Macquarie-Aerospace-Rover-Society/schematics/README.md

# ALL THINGS ELECTRICAL
All the schematics and manufacturing files will be located here.

If there are any requests, corrections or objections, please direct them at @sunnyshenao on the MQ rover discord.
