Macquarie-Aerospace-Rover-Society/schematics/mqmars.kicad_pcb

## KiCad design mqmars.kicad_pcb (2024-12-28)

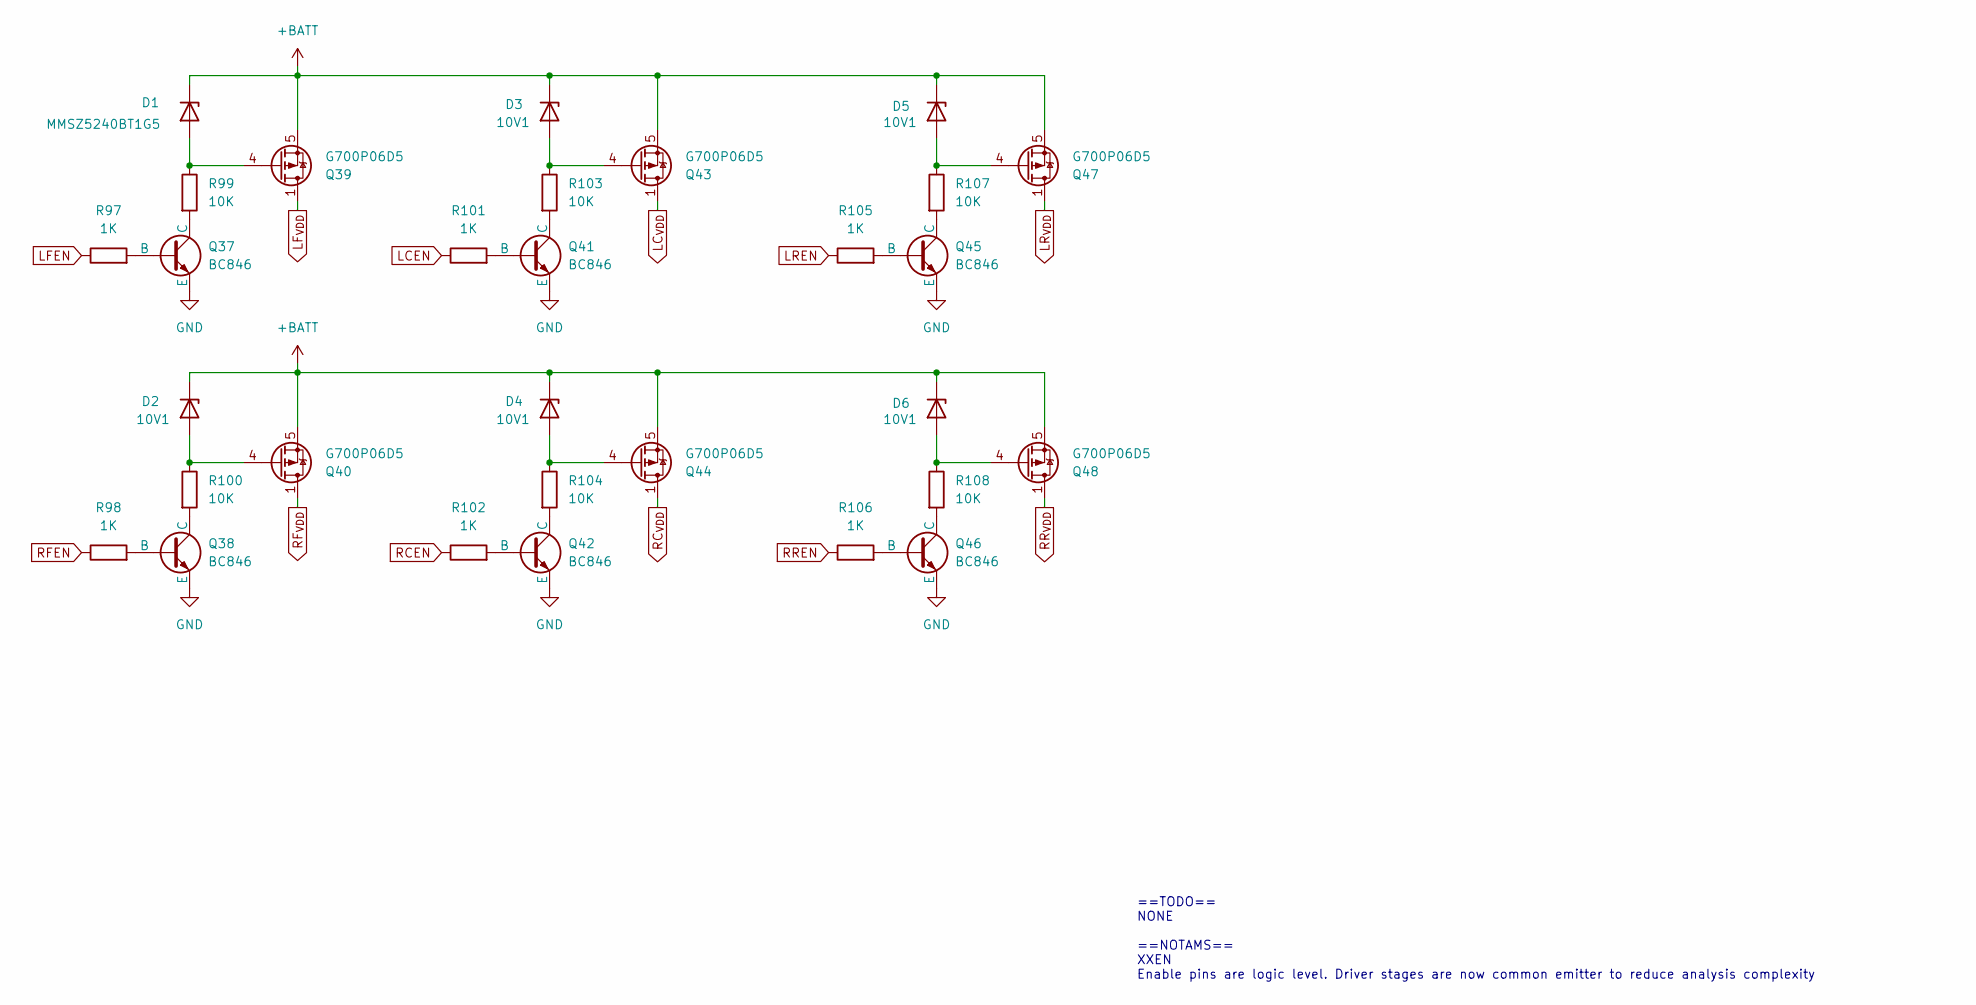
[picture p1: schematic PDU.kicad_sch, MQ Rover Controller]

Parts:
D1: MMSZ5240BT1G5; D_SOD-123
D2, D3, D4, D5, D6: 10V1; D_SOD-123
Q37, Q38, Q41, Q42, Q45, Q46: BC846; SOT-23
Q39, Q40, Q43, Q44, Q47, Q48: G700P06D5; PowerPAK_SO-8_Single
R97, R98, R101, R102, R105, R106: 1K; R_0201_0603Metric
R99, R100, R103, R104, R107, R108: 10K; R_1210_3225Metric

Connections:
+BATT: D1.1 (K), D2.1 (K), D3.1 (K), D4.1 (K), D5.1 (K), D6.1 (K), Q39.5 (S), Q40.5 (S), Q43.5 (S), Q44.5 (S), Q47.5 (S), Q48.5 (S); also elsewhere on the board
GND: Q37.3 (E), Q38.3 (E), Q41.3 (E), Q42.3 (E), Q45.3 (E), Q46.3 (E); also elsewhere on the board
LCEN: R101.1; also elsewhere on the board
LC_{VDD}: Q43.1 (D), Q43.2 (D), Q43.3 (D); also elsewhere on the board
LFEN: R97.1; also elsewhere on the board
LF_{VDD}: Q39.1 (D), Q39.2 (D), Q39.3 (D); also elsewhere on the board
LREN: R105.1; also elsewhere on the board
LR_{VDD}: Q47.1 (D), Q47.2 (D), Q47.3 (D); also elsewhere on the board
unnamed: D1.2 (A), Q39.4 (G), R99.1
unnamed: D2.2 (A), Q40.4 (G), R100.1
unnamed: D3.2 (A), Q43.4 (G), R103.1
unnamed: D4.2 (A), Q44.4 (G), R104.1
unnamed: D5.2 (A), Q47.4 (G), R107.1
unnamed: D6.2 (A), Q48.4 (G), R108.1
unnamed: Q37.2 (B), R97.2
unnamed: Q37.1 (C), R99.2
unnamed: Q38.2 (B), R98.2
unnamed: Q38.1 (C), R100.2
unnamed: Q41.2 (B), R101.2
unnamed: Q41.1 (C), R103.2
unnamed: Q42.2 (B), R102.2
unnamed: Q42.1 (C), R104.2
unnamed: Q45.2 (B), R105.2
unnamed: Q45.1 (C), R107.2
unnamed: Q46.2 (B), R106.2
unnamed: Q46.1 (C), R108.2
RCEN: R102.1; also elsewhere on the board
RC_{VDD}: Q44.1 (D), Q44.2 (D), Q44.3 (D); also elsewhere on the board
RFEN: R98.1; also elsewhere on the board
RF_{VDD}: Q40.1 (D), Q40.2 (D), Q40.3 (D); also elsewhere on the board
RREN: R106.1; also elsewhere on the board
RR_{VDD}: Q48.1 (D), Q48.2 (D), Q48.3 (D); also elsewhere on the board

Notes on the sheet:
==TODO== NONE ==NOTAMS== XXEN Enable pins are logic level. Driver stages are now common emitter to reduce analysis complexity

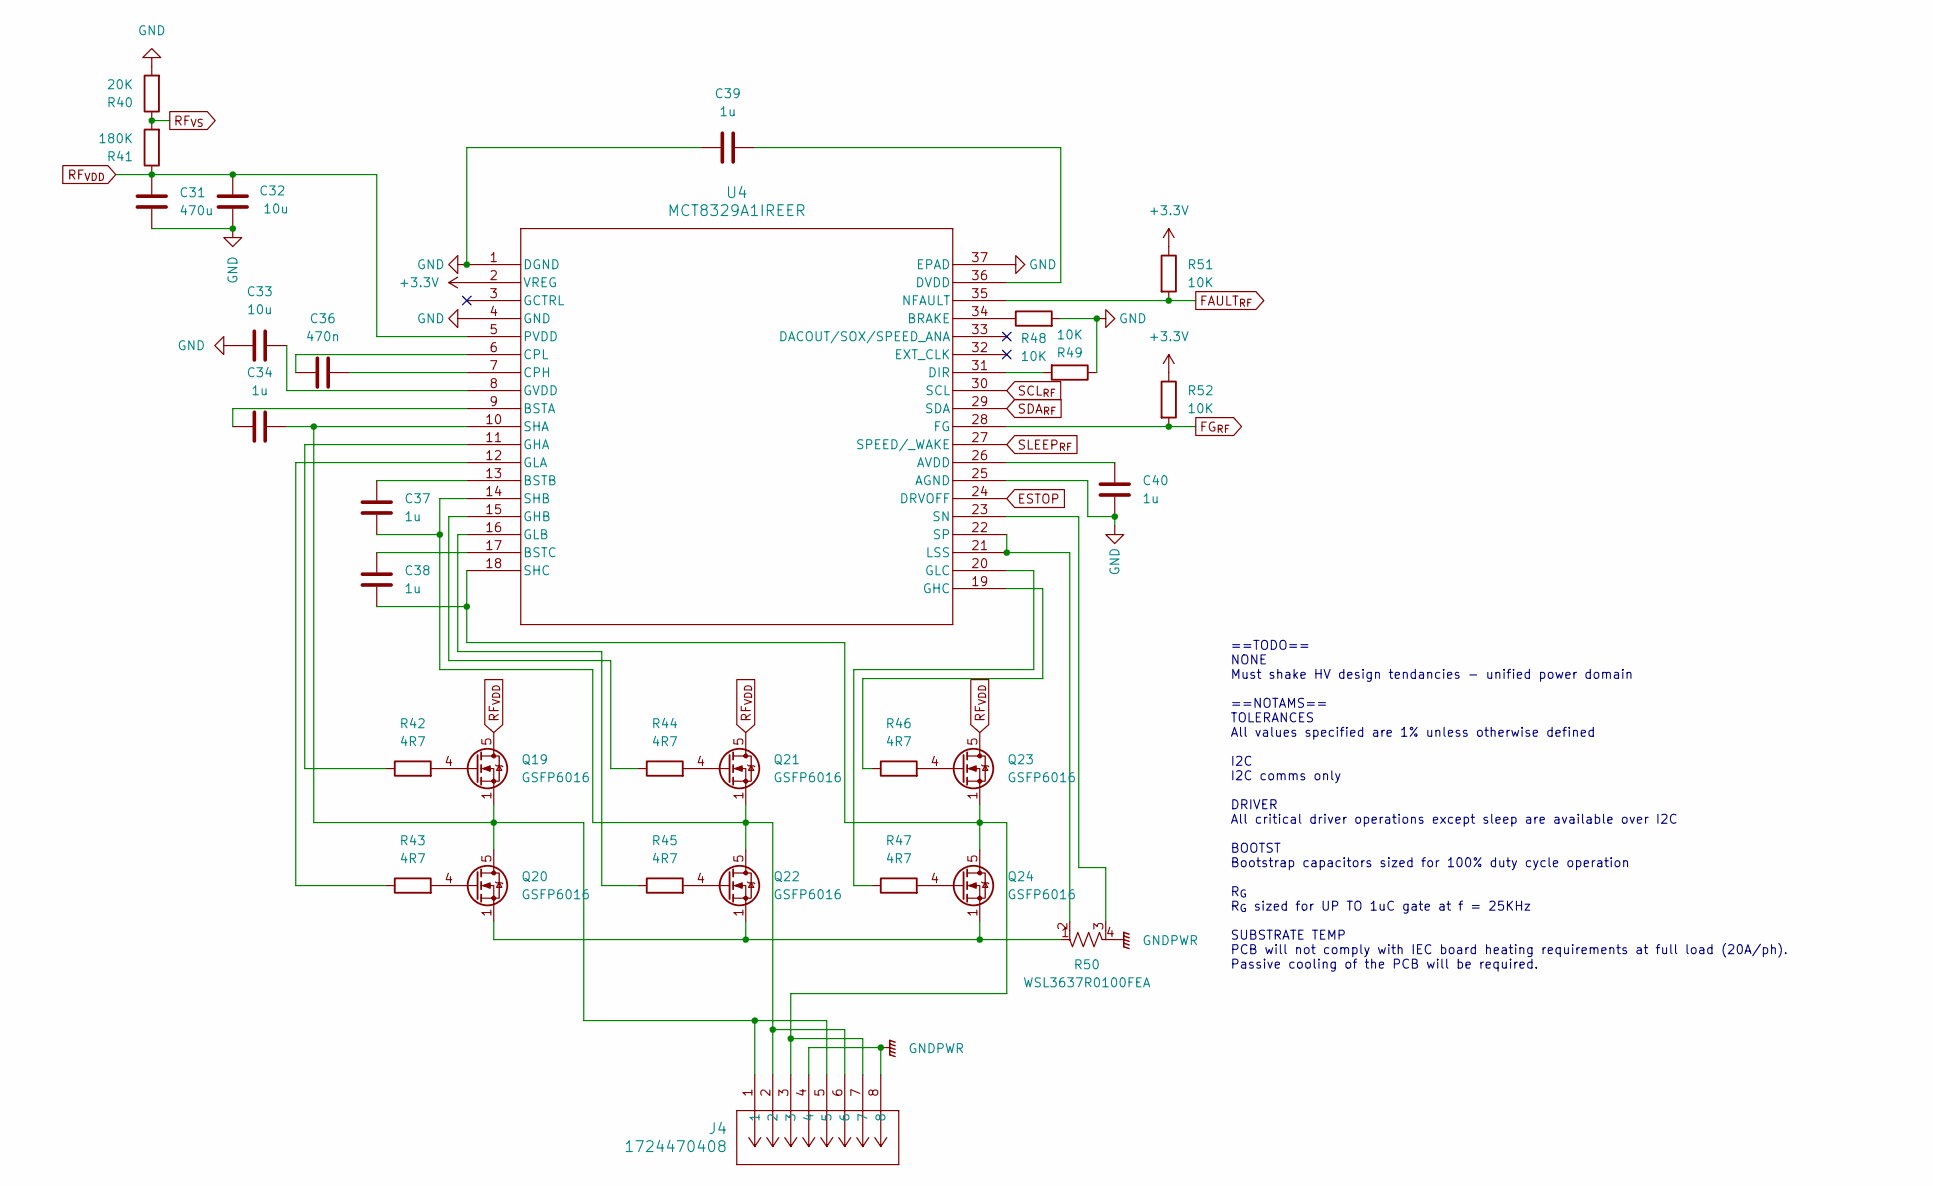
[picture p2: schematic RF.kicad_sch, MQ Rover Controller]

Parts:
C31: 470u; CP_Radial_D10.0mm_P5.00mm
C32: 10u; C_1210_3225Metric
C33: 10u; C_0402_1005Metric
C34, C37, C38, C39, C40: 1u; C_0201_0603Metric
C36: 470n; C_0201_0603Metric
J4: 1724470408; CONN08_1724470408_MOL
Q19, Q20, Q21, Q22, Q23, Q24: GSFP6016; PowerPAK_SO-8_Single
R40: 20K; R_0201_0603Metric
R41: 180K; R_0201_0603Metric
R42, R43, R44, R45, R46, R47: 4R7; R_0603_1608Metric
R48, R49, R51, R52: 10K; R_0201_0603Metric
R50: WSL3637R0100FEA; WSL3637_VIS
U4: MCT8329A1IREER; WQFN36_REE_TEX

Connections:
+3.3V: R51.1, R52.1, U4.2 (VREG); also elsewhere on the board
ESTOP: U4.24 (DRVOFF); also elsewhere on the board
FAULT_{RF}: R51.2, U4.35 (NFAULT); also elsewhere on the board
FG_{RF}: R52.2, U4.28 (FG)
GND: C31.2, C32.2, C33.1, C39.1, C40.1, R40.2, R48.2, R49.1, U4.1 (DGND), U4.4 (GND), U4.25 (AGND), U4.37 (EPAD); also elsewhere on the board
GNDPWR: J4.4, J4.8, R50.4; also elsewhere on the board
unnamed: Q19.4 (G), R42.2
unnamed: C34.1, J4.1, J4.5, Q19.1 (S), Q19.2 (S), Q19.3 (S), Q20.5 (D), U4.10 (SHA)
unnamed: Q20.4 (G), R43.2
unnamed: Q20.1 (S), Q20.2 (S), Q20.3 (S), Q22.1 (S), Q22.2 (S), Q22.3 (S), Q24.1 (S), Q24.2 (S), Q24.3 (S), R50.1
unnamed: Q21.4 (G), R44.2
unnamed: C37.2, J4.2, J4.6, Q21.1 (S), Q21.2 (S), Q21.3 (S), Q22.5 (D), U4.14 (SHB)
unnamed: Q22.4 (G), R45.2
unnamed: Q23.4 (G), R46.2
unnamed: C38.2, J4.3, J4.7, Q23.1 (S), Q23.2 (S), Q23.3 (S), Q24.5 (D), U4.18 (SHC)
unnamed: Q24.4 (G), R47.2
unnamed: C40.2, U4.26 (AVDD)
unnamed: R48.1, U4.34 (BRAKE)
unnamed: C34.2, U4.9 (BSTA)
unnamed: C37.1, U4.13 (BSTB)
unnamed: C38.1, U4.17 (BSTC)
unnamed: C36.1, U4.7 (CPH)
unnamed: C36.2, U4.6 (CPL)
unnamed: R49.2, U4.31 (DIR)
unnamed: C39.2, U4.36 (DVDD)
unnamed: R42.1, U4.11 (GHA)
unnamed: R44.1, U4.15 (GHB)
unnamed: R46.1, U4.19 (GHC)
unnamed: R43.1, U4.12 (GLA)
unnamed: R45.1, U4.16 (GLB)
unnamed: R47.1, U4.20 (GLC)
unnamed: C33.2, U4.8 (GVDD)
unnamed: R50.2, U4.21 (LSS), U4.22 (SP)
unnamed: R50.3, U4.23 (SN)
RF_{VDD}: C31.1, C32.1, Q19.5 (D), Q21.5 (D), Q23.5 (D), R41.1, U4.5 (PVDD); also elsewhere on the board
RF_{VS}: R40.1, R41.2; also elsewhere on the board
SCL_{RF}: U4.30 (SCL); also elsewhere on the board
SDA_{RF}: U4.29 (SDA); also elsewhere on the board
SLEEP_{RF}: U4.27 (SPEED/_WAKE)

Notes on the sheet:
==TODO== NONE Must shake HV design tendancies - unified power domain ==NOTAMS== TOLERANCES All values specified are 1% unless otherwise defined I2C I2C comms only DRIVER All critical driver operations except sleep are available over I2C BOOTST Bootstrap capacitors sized for 100% duty cycle operatio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

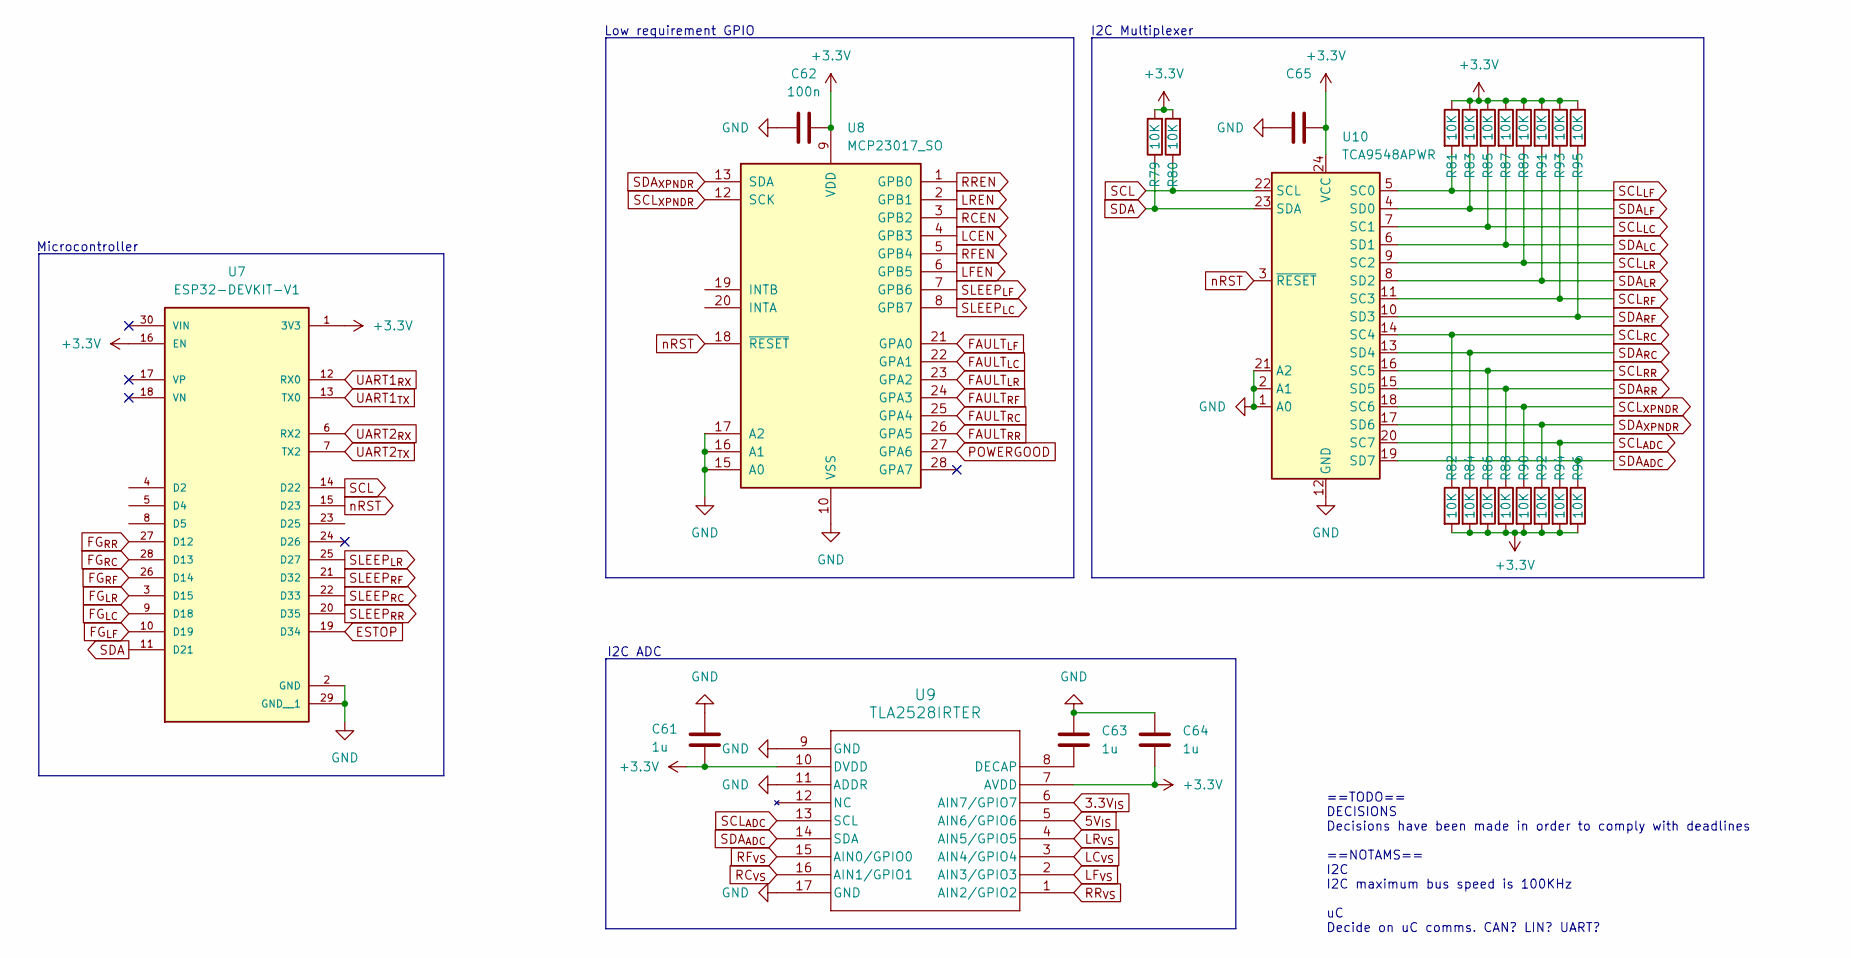
[picture p3: schematic Interposer.kicad_sch, MQ Rover Controller]

Parts:
C61, C63, C64: 1u; C_0201_0603Metric
C62: 100n; C_0201_0603Metric
C65: C_0201_0603Metric
R79, R80, R81, R82, R83, R84, R85, R86, R87, R88, R89, R90, R91, R92, R93, R94, R95, R96: 10K; R_0201_0603Metric
U7: ESP32-DEVKIT-V1; MODULE_ESP32_DEVKIT_V1; PARTREV N/A
U8: MCP23017_SO; SOIC-28W_7.5x17.9mm_P1.27mm
U9: TLA2528IRTER; WQFN16_RTE_TEX
U10: TCA9548APWR; TSSOP-24_4.4x7.8mm_P0.65mm

Connections:
3.3V_{IS}: U9.6 (AIN7/GPIO7); also elsewhere on the board
5V_{IS}: U9.5 (AIN6/GPIO6); also elsewhere on the board
+3.3V: C61.1, C62.2, C64.2, C65.2, R79.2, R80.2, R81.1, R82.2, R83.1, R84.2, R85.1, R86.2, R87.1, R88.2, R89.1, R90.2, R91.1, R92.2, R93.1, R94.2, R95.1, R96.2, U7.1 (3V3), U7.16 (EN), U8.9 (VDD), U9.7 (AVDD), U9.10 (DVDD), U10.24 (VCC); also elsewhere on the board
FAULT_{LC}: U8.22 (GPA1); also elsewhere on the board
FAULT_{LF}: U8.21 (GPA0); also elsewhere on the board
FAULT_{LR}: U8.23 (GPA2); also elsewhere on the board
FAULT_{RC}: U8.25 (GPA4); also elsewhere on the board
FAULT_{RF}: U8.24 (GPA3); also elsewhere on the board
FAULT_{RR}: U8.26 (GPA5); also elsewhere on the board
GND: C61.2, C62.1, C63.1, C64.1, C65.1, U7.2 (GND), U7.29 (GND__1), U8.10 (VSS), U8.15 (A0), U8.16 (A1), U8.17 (A2), U9.9 (GND), U9.11 (ADDR), U9.17 (GND), U10.1 (A0), U10.2 (A1), U10.12 (GND), U10.21 (A2); also elsewhere on the board
LCEN: U8.4 (GPB3); also elsewhere on the board
LC_{VS}: U9.3 (AIN4/GPIO4); also elsewhere on the board
LFEN: U8.6 (GPB5); also elsewhere on the board
LF_{VS}: U9.2 (AIN3/GPIO3); also elsewhere on the board
LREN: U8.2 (GPB1); also elsewhere on the board
LR_{VS}: U9.4 (AIN5/GPIO5); also elsewhere on the board
unnamed: C63.2, U9.8 (DECAP)
POWERGOOD: U8.27 (GPA6); also elsewhere on the board
RCEN: U8.3 (GPB2); also elsewhere on the board
RC_{VS}: U9.16 (AIN1/GPIO1); also elsewhere on the board
RFEN: U8.5 (GPB4); also elsewhere on the board
RF_{VS}: U9.15 (AIN0/GPIO0); also elsewhere on the board
RREN: U8.1 (GPB0); also elsewhere on the board
RR_{VS}: U9.1 (AIN2/GPIO2); also elsewhere on the board
SCL: R80.1, U7.14 (D22), U10.22 (SCL)
SCL_{ADC}: R94.1, U9.13 (SCL), U10.20 (SC7)
SCL_{LC}: R85.2, U10.7 (SC1); also elsewhere on the board
SCL_{LF}: R81.2, U10.5 (SC0); also elsewhere on the board
SCL_{LR}: R89.2, U10.9 (SC2); also elsewhere on the board
SCL_{RC}: R82.1, U10.14 (SC4); also elsewhere on the board
SCL_{RF}: R93.2, U10.11 (SC3); also elsewhere on the board
SCL_{RR}: R86.1, U10.16 (SC5); also elsewhere on the board
SCL_{XPNDR}: R90.1, U8.12 (SCK), U10.18 (SC6)
SDA: R79.1, U7.11 (D21), U10.23 (SDA)
SDA_{ADC}: R96.1, U9.14 (SDA), U10.19 (SD7)
SDA_{LC}: R87.2, U10.6 (SD1); also elsewhere on the board
SDA_{LF}: R83.2, U10.4 (SD0); also elsewhere on the board
SDA_{LR}: R91.2, U10.8 (SD2); also elsewhere on the board
SDA_{RC}: R84.1, U10.13 (SD4); also elsewhere on the board
SDA_{RF}: R95.2, U10.10 (SD3); also elsewhere on the board
SDA_{RR}: R88.1, U10.15 (SD5); also elsewhere on the board
SDA_{XPNDR}: R92.1, U8.13 (SDA), U10.17 (SD6)
SLEEP_{LC}: U8.8 (GPB7); also elsewhere on the board
SLEEP_{LF}: U8.7 (GPB6); also elsewhere on the board
nRST: U7.15 (D23), U8.18 (~RESET), U10.3 (~RESET)

Notes on the sheet:
==TODO== DECISIONS Decisions have been made in order to comply with deadlines ==NOTAMS== I2C I2C maximum bus speed is 100KHz uC Decide on uC comms. CAN? LIN? UART?
I2C Multiplexer
Microcontroller
Low requirement GPIO
I2C ADC

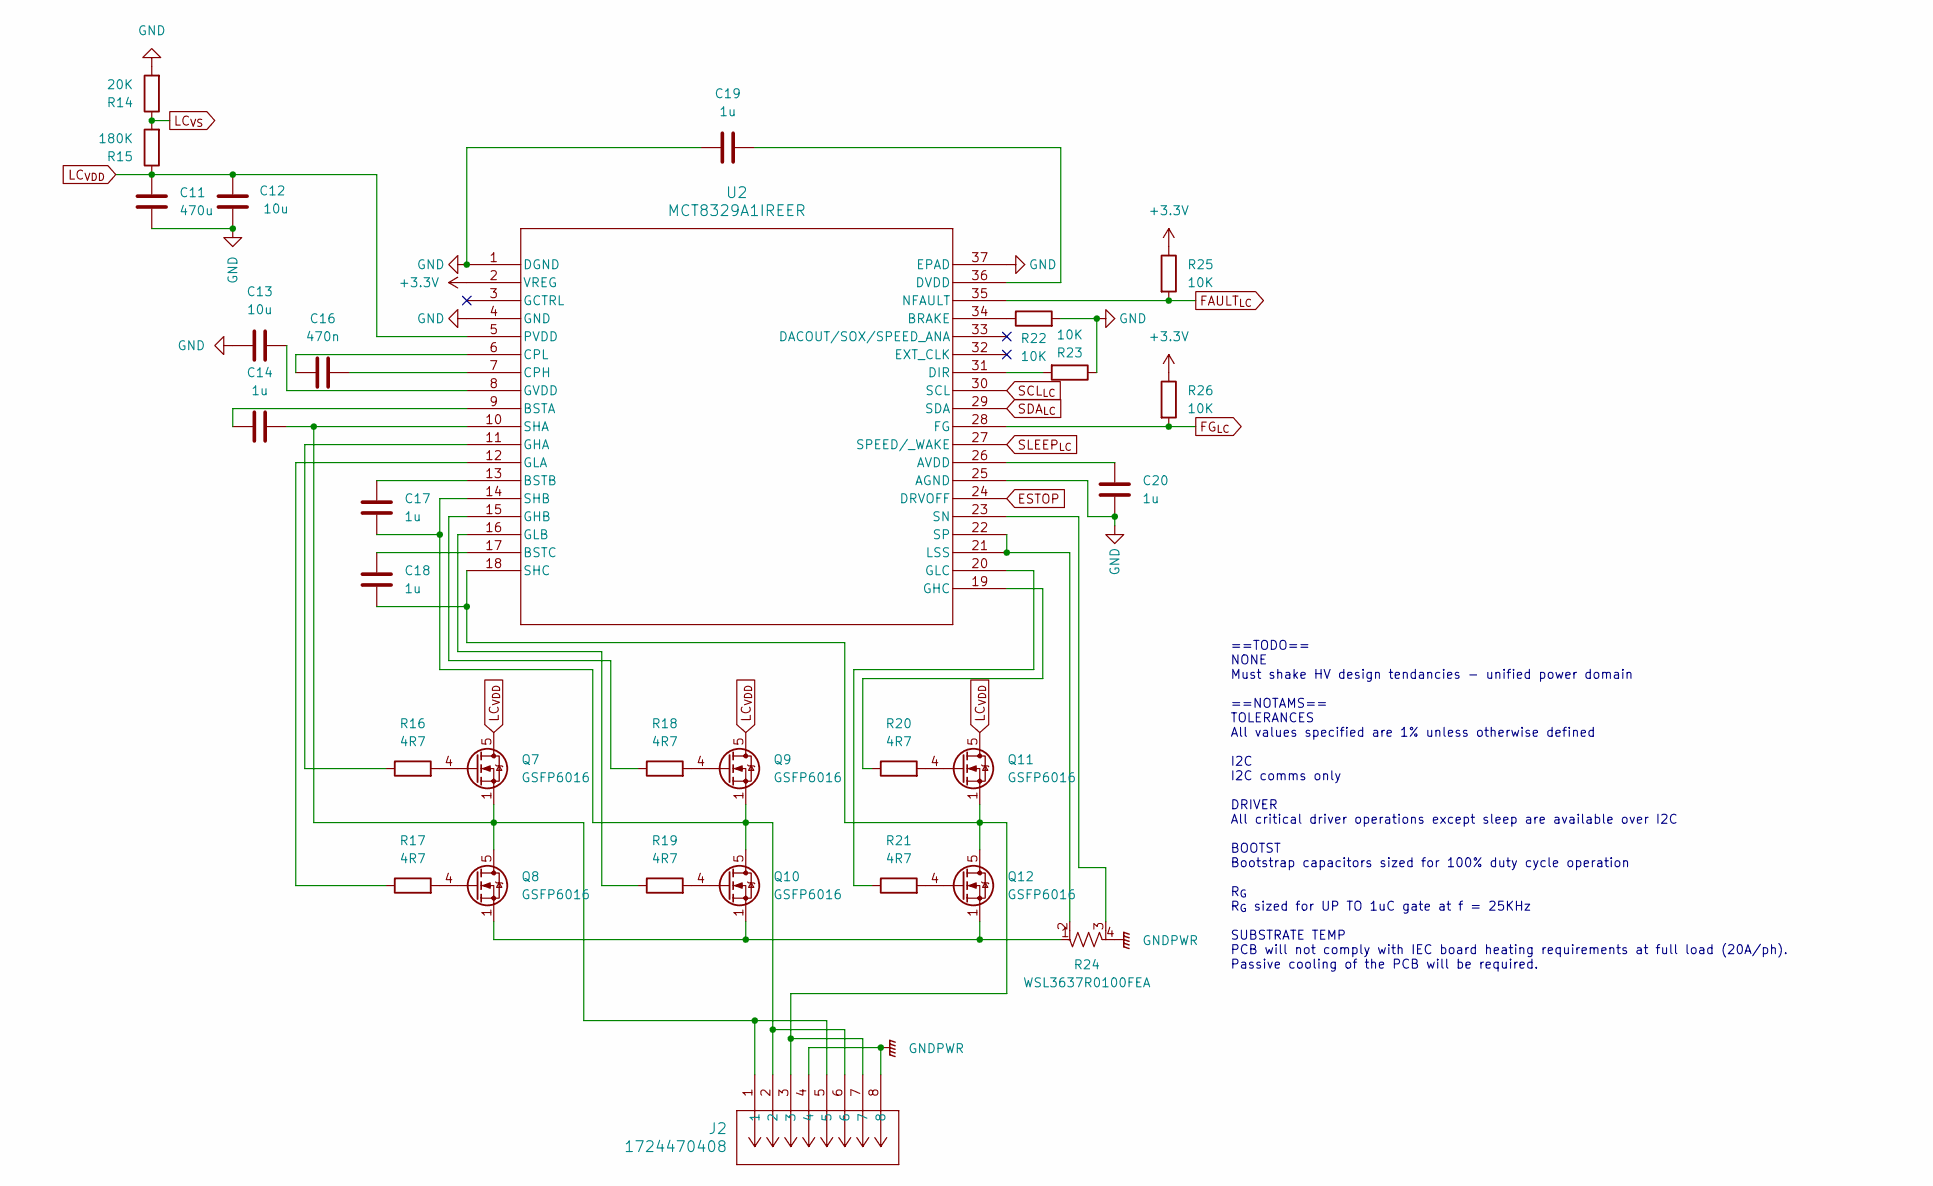
[picture p4: schematic LC.kicad_sch, MQ Rover Controller]

Parts:
C11: 470u; CP_Radial_D10.0mm_P5.00mm
C12: 10u; C_1210_3225Metric
C13: 10u; C_0402_1005Metric
C14, C17, C18, C19, C20: 1u; C_0201_0603Metric
C16: 470n; C_0201_0603Metric
J2: 1724470408; CONN08_1724470408_MOL
Q7, Q8, Q9, Q10, Q11, Q12: GSFP6016; PowerPAK_SO-8_Single
R14: 20K; R_0201_0603Metric
R15: 180K; R_0201_0603Metric
R16, R17, R18, R19, R20, R21: 4R7; R_0603_1608Metric
R22, R23, R25, R26: 10K; R_0201_0603Metric
R24: WSL3637R0100FEA; WSL3637_VIS
U2: MCT8329A1IREER; WQFN36_REE_TEX

Connections:
+3.3V: R25.1, R26.1, U2.2 (VREG); also elsewhere on the board
ESTOP: U2.24 (DRVOFF); also elsewhere on the board
FAULT_{LC}: R25.2, U2.35 (NFAULT); also elsewhere on the board
FG_{LC}: R26.2, U2.28 (FG)
GND: C11.2, C12.2, C13.1, C19.1, C20.1, R14.2, R22.2, R23.1, U2.1 (DGND), U2.4 (GND), U2.25 (AGND), U2.37 (EPAD); also elsewhere on the board
GNDPWR: J2.4, J2.8, R24.4; also elsewhere on the board
LC_{VDD}: C11.1, C12.1, Q7.5 (D), Q9.5 (D), Q11.5 (D), R15.1, U2.5 (PVDD); also elsewhere on the board
LC_{VS}: R14.1, R15.2; also elsewhere on the board
unnamed: Q7.4 (G), R16.2
unnamed: C14.1, J2.1, J2.5, Q7.1 (S), Q7.2 (S), Q7.3 (S), Q8.5 (D), U2.10 (SHA)
unnamed: Q8.4 (G), R17.2
unnamed: Q9.4 (G), R18.2
unnamed: C17.2, J2.2, J2.6, Q9.1 (S), Q9.2 (S), Q9.3 (S), Q10.5 (D), U2.14 (SHB)
unnamed: Q10.4 (G), R19.2
unnamed: Q8.1 (S), Q8.2 (S), Q8.3 (S), Q10.1 (S), Q10.2 (S), Q10.3 (S), Q12.1 (S), Q12.2 (S), Q12.3 (S), R24.1
unnamed: Q11.4 (G), R20.2
unnamed: C18.2, J2.3, J2.7, Q11.1 (S), Q11.2 (S), Q11.3 (S), Q12.5 (D), U2.18 (SHC)
unnamed: Q12.4 (G), R21.2
unnamed: C20.2, U2.26 (AVDD)
unnamed: R22.1, U2.34 (BRAKE)
unnamed: C14.2, U2.9 (BSTA)
unnamed: C17.1, U2.13 (BSTB)
unnamed: C18.1, U2.17 (BSTC)
unnamed: C16.1, U2.7 (CPH)
unnamed: C16.2, U2.6 (CPL)
unnamed: R23.2, U2.31 (DIR)
unnamed: C19.2, U2.36 (DVDD)
unnamed: R16.1, U2.11 (GHA)
unnamed: R18.1, U2.15 (GHB)
unnamed: R20.1, U2.19 (GHC)
unnamed: R17.1, U2.12 (GLA)
unnamed: R19.1, U2.16 (GLB)
unnamed: R21.1, U2.20 (GLC)
unnamed: C13.2, U2.8 (GVDD)
unnamed: R24.2, U2.21 (LSS), U2.22 (SP)
unnamed: R24.3, U2.23 (SN)
SCL_{LC}: U2.30 (SCL); also elsewhere on the board
SDA_{LC}: U2.29 (SDA); also elsewhere on the board
SLEEP_{LC}: U2.27 (SPEED/_WAKE); also elsewhere on the board

Notes on the sheet:
==TODO== NONE Must shake HV design tendancies - unified power domain ==NOTAMS== TOLERANCES All values specified are 1% unless otherwise defined I2C I2C comms only DRIVER All critical driver operations except sleep are available over I2C BOOTST Bootstrap capacitors sized for 100% duty cycle operatio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

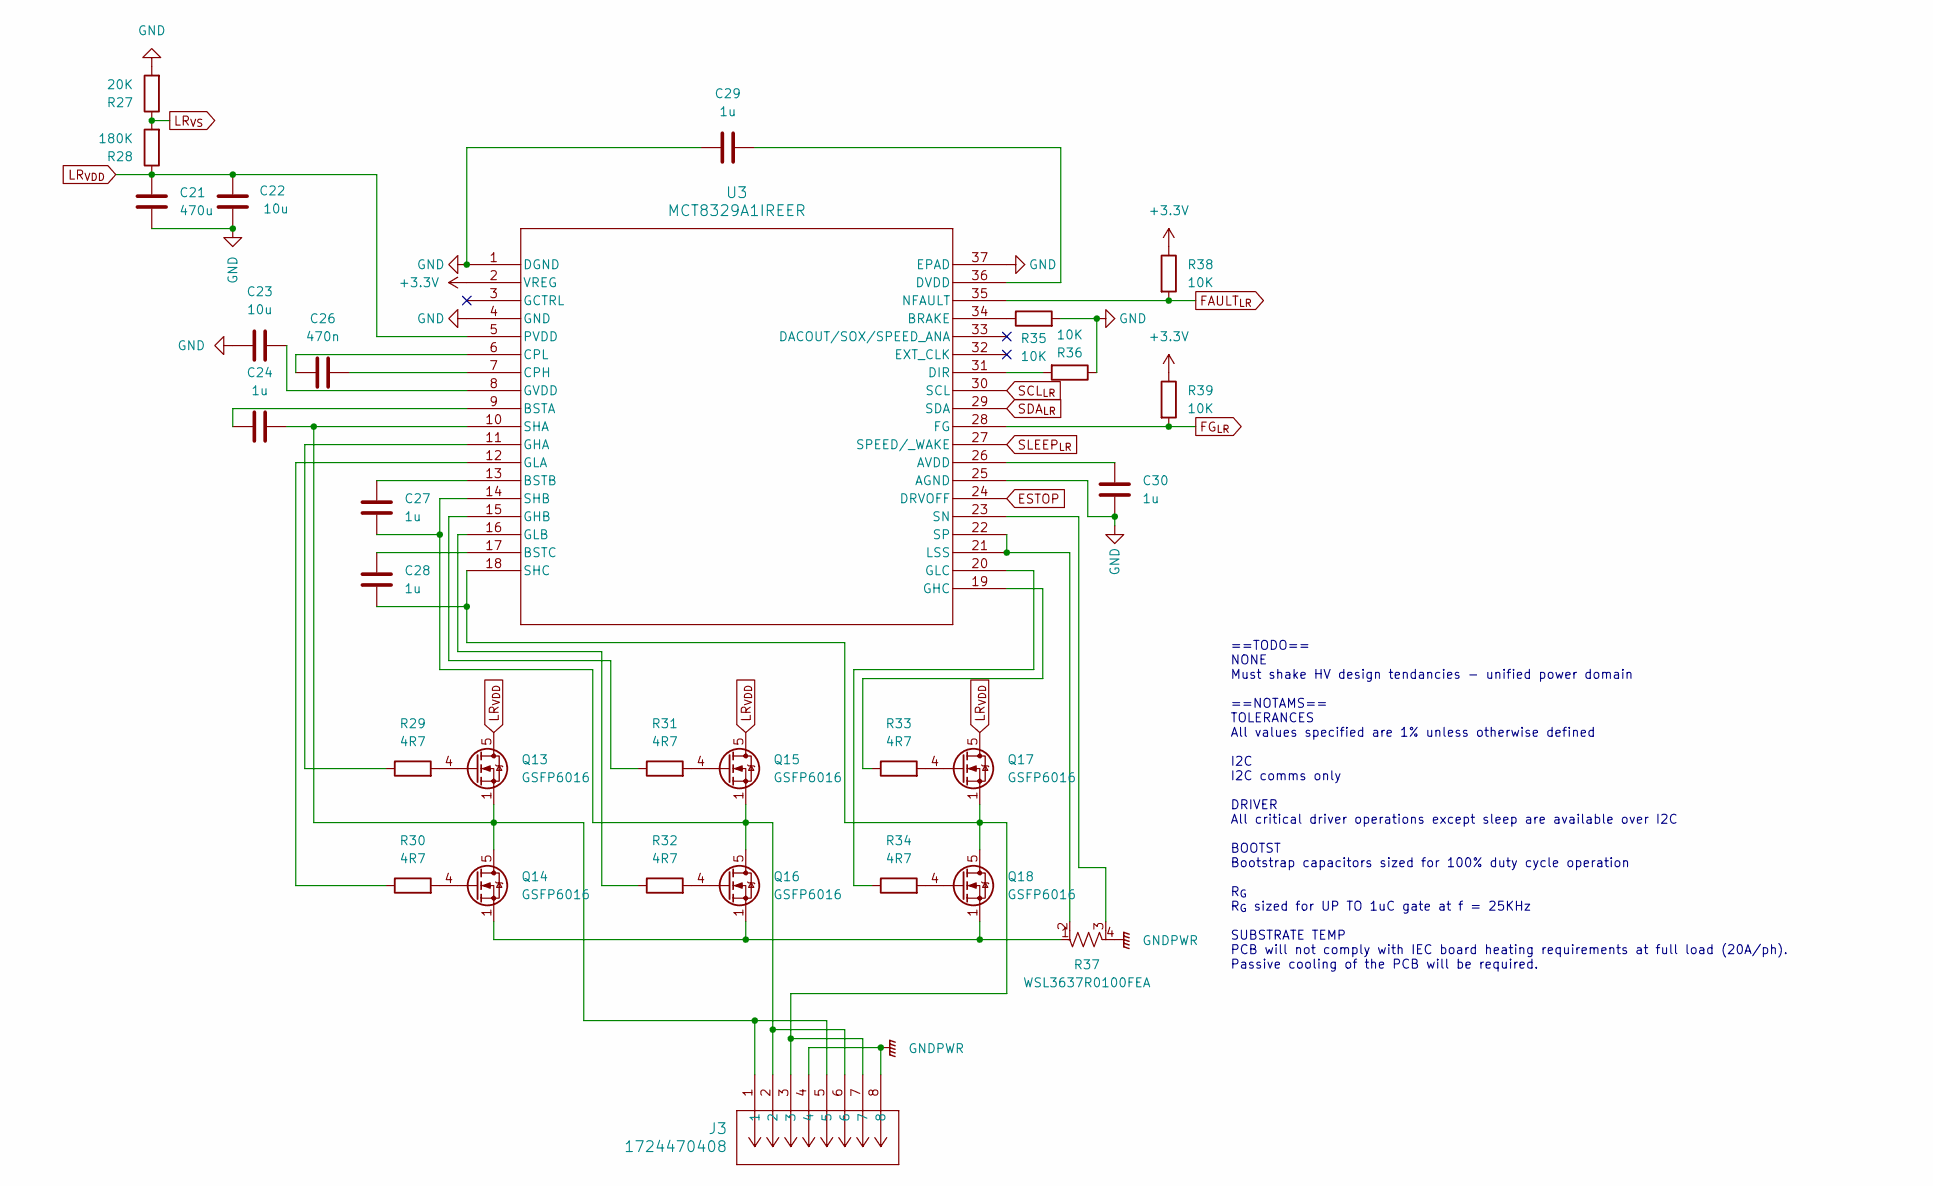
[picture p5: schematic LR.kicad_sch, MQ Rover Controller]

Parts:
C21: 470u; CP_Radial_D10.0mm_P5.00mm
C22: 10u; C_1210_3225Metric
C23: 10u; C_0402_1005Metric
C24, C27, C28, C29, C30: 1u; C_0201_0603Metric
C26: 470n; C_0201_0603Metric
J3: 1724470408; CONN08_1724470408_MOL
Q13, Q14, Q15, Q16, Q17, Q18: GSFP6016; PowerPAK_SO-8_Single
R27: 20K; R_0201_0603Metric
R28: 180K; R_0201_0603Metric
R29, R30, R31, R32, R33, R34: 4R7; R_0603_1608Metric
R35, R36, R38, R39: 10K; R_0201_0603Metric
R37: WSL3637R0100FEA; WSL3637_VIS
U3: MCT8329A1IREER; WQFN36_REE_TEX

Connections:
+3.3V: R38.1, R39.1, U3.2 (VREG); also elsewhere on the board
ESTOP: U3.24 (DRVOFF); also elsewhere on the board
FAULT_{LR}: R38.2, U3.35 (NFAULT); also elsewhere on the board
FG_{LR}: R39.2, U3.28 (FG)
GND: C21.2, C22.2, C23.1, C29.1, C30.1, R27.2, R35.2, R36.1, U3.1 (DGND), U3.4 (GND), U3.25 (AGND), U3.37 (EPAD); also elsewhere on the board
GNDPWR: J3.4, J3.8, R37.4; also elsewhere on the board
LR_{VDD}: C21.1, C22.1, Q13.5 (D), Q15.5 (D), Q17.5 (D), R28.1, U3.5 (PVDD); also elsewhere on the board
LR_{VS}: R27.1, R28.2; also elsewhere on the board
unnamed: Q13.4 (G), R29.2
unnamed: C24.1, J3.1, J3.5, Q13.1 (S), Q13.2 (S), Q13.3 (S), Q14.5 (D), U3.10 (SHA)
unnamed: Q14.4 (G), R30.2
unnamed: Q14.1 (S), Q14.2 (S), Q14.3 (S), Q16.1 (S), Q16.2 (S), Q16.3 (S), Q18.1 (S), Q18.2 (S), Q18.3 (S), R37.1
unnamed: Q15.4 (G), R31.2
unnamed: C27.2, J3.2, J3.6, Q15.1 (S), Q15.2 (S), Q15.3 (S), Q16.5 (D), U3.14 (SHB)
unnamed: Q16.4 (G), R32.2
unnamed: Q17.4 (G), R33.2
unnamed: C28.2, J3.3, J3.7, Q17.1 (S), Q17.2 (S), Q17.3 (S), Q18.5 (D), U3.18 (SHC)
unnamed: Q18.4 (G), R34.2
unnamed: C30.2, U3.26 (AVDD)
unnamed: R35.1, U3.34 (BRAKE)
unnamed: C24.2, U3.9 (BSTA)
unnamed: C27.1, U3.13 (BSTB)
unnamed: C28.1, U3.17 (BSTC)
unnamed: C26.1, U3.7 (CPH)
unnamed: C26.2, U3.6 (CPL)
unnamed: R36.2, U3.31 (DIR)
unnamed: C29.2, U3.36 (DVDD)
unnamed: R29.1, U3.11 (GHA)
unnamed: R31.1, U3.15 (GHB)
unnamed: R33.1, U3.19 (GHC)
unnamed: R30.1, U3.12 (GLA)
unnamed: R32.1, U3.16 (GLB)
unnamed: R34.1, U3.20 (GLC)
unnamed: C23.2, U3.8 (GVDD)
unnamed: R37.2, U3.21 (LSS), U3.22 (SP)
unnamed: R37.3, U3.23 (SN)
SCL_{LR}: U3.30 (SCL); also elsewhere on the board
SDA_{LR}: U3.29 (SDA); also elsewhere on the board
SLEEP_{LR}: U3.27 (SPEED/_WAKE)

Notes on the sheet:
==TODO== NONE Must shake HV design tendancies - unified power domain ==NOTAMS== TOLERANCES All values specified are 1% unless otherwise defined I2C I2C comms only DRIVER All critical driver operations except sleep are available over I2C BOOTST Bootstrap capacitors sized for 100% duty cycle operatio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

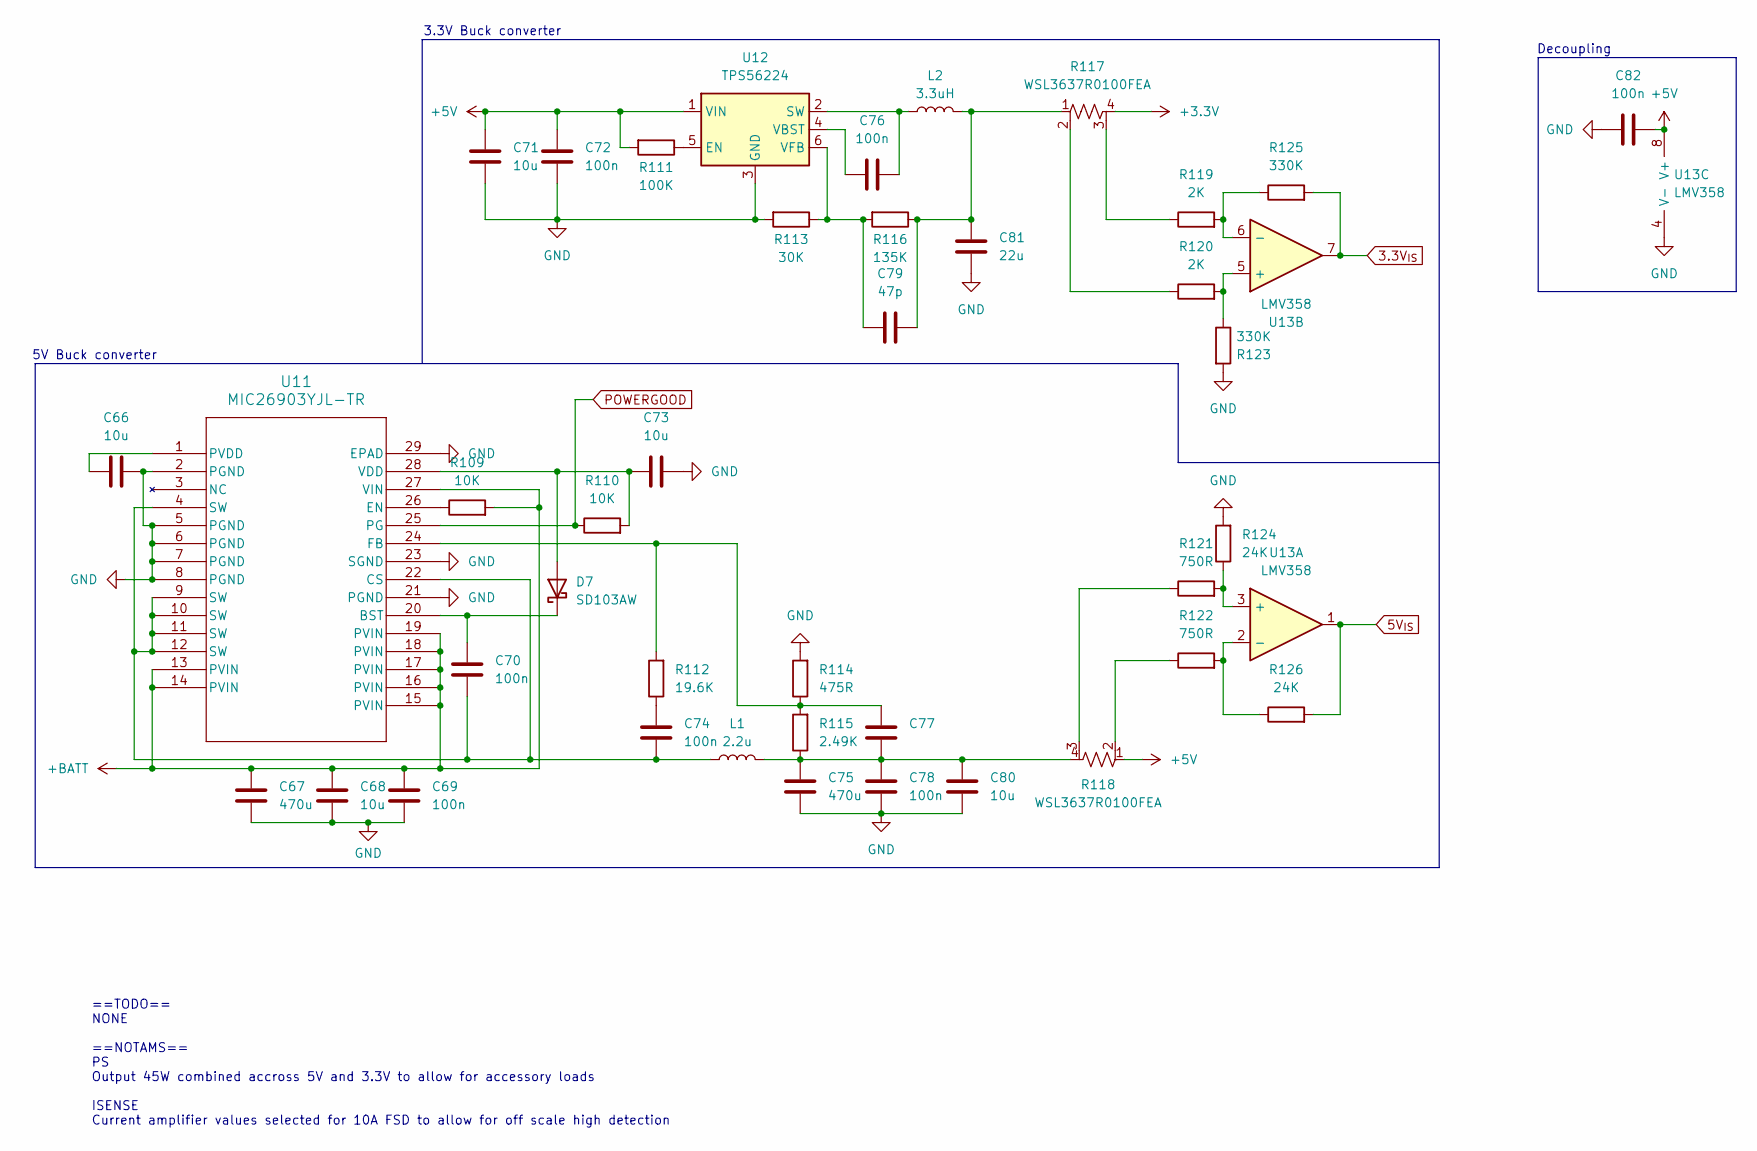
[picture p6: schematic PS.kicad_sch, MQ Rover Controller]

Parts:
C66, C71, C73: 10u; C_0402_1005Metric
C67, C75: 470u; C_0603_1608Metric
C68, C80: 10u; C_0603_1608Metric
C69, C74, C78: 100n; C_0603_1608Metric
C70, C72, C76, C82: 100n; C_0201_0603Metric
C77: C_0201_0603Metric
C79: 47p; C_0201_0603Metric
C81: 22u; C_0603_1608Metric
D7: SD103AW; D_SOD-123
L1: 2.2u; L_Bourns_SRN8040TA
L2: 3.3uH; L_Coilcraft_LPS3314
R109, R110: 10K; R_0603_1608Metric
R111: 100K; R_0603_1608Metric
R112: 19.6K; R_0603_1608Metric
R113: 30K; R_0603_1608Metric
R114: 475R; R_0603_1608Metric
R115: 2.49K; R_0603_1608Metric
R116: 135K; R_0603_1608Metric
R117, R118: WSL3637R0100FEA; WSL3637_VIS
R119, R120: 2K; R_0603_1608Metric
R121, R122: 750R; R_0603_1608Metric
R123, R125: 330K; R_0603_1608Metric
R124, R126: 24K; R_0603_1608Metric
U11: MIC26903YJL-TR; MLF28_5X6_MCH
U12: TPS56224; SOT-563
U13: LMV358; VSSOP-8_3x3mm_P0.65mm

Connections:
3.3V_{IS}: R125.2, U13.7; also elsewhere on the board
5V_{IS}: R126.2, U13.1; also elsewhere on the board
+3.3V: R117.4; also elsewhere on the board
+5V: C71.1, C72.1, C82.2, R111.2, R118.1, U12.1 (VIN), U13.8 (V+)
+BATT: C67.2, C68.2, C69.2, R109.2, U11.13 (PVIN), U11.14 (PVIN), U11.15 (PVIN), U11.16 (PVIN), U11.17 (PVIN), U11.18 (PVIN), U11.19 (PVIN), U11.27 (VIN); also elsewhere on the board
GND: C66.1, C67.1, C68.1, C69.1, C71.2, C72.2, C73.1, C75.1, C78.1, C80.1, C81.2, C82.1, R113.2, R114.2, R123.2, R124.2, U11.2 (PGND), U11.5 (PGND), U11.6 (PGND), U11.7 (PGND), U11.8 (PGND), U11.21 (PGND), U11.23 (SGND), U11.29 (EPAD), U12.3 (GND), U13.4 (V-); also elsewhere on the board
unnamed: C74.1, R112.1
unnamed: C75.2, C77.2, C78.2, C80.2, L1.2, R115.1, R118.4
unnamed: C79.1, C81.1, L2.2, R116.1, R117.1
unnamed: C73.2, D7.2 (A), R110.2, U11.28 (VDD)
unnamed: C70.1, D7.1 (K), U11.20 (BST)
unnamed: R117.2, R120.1
unnamed: R117.3, R119.1
unnamed: R118.2, R122.1
unnamed: R118.3, R121.1
unnamed: C70.2, C74.2, L1.1, U11.4 (SW), U11.9 (SW), U11.10 (SW), U11.11 (SW), U11.12 (SW), U11.22 (CS)
unnamed: R109.1, U11.26 (EN)
unnamed: C77.1, R112.2, R114.1, R115.2, U11.24 (FB)
unnamed: C66.2, U11.1 (PVDD)
unnamed: R111.1, U12.5 (EN)
unnamed: C76.1, L2.1, U12.2 (SW)
unnamed: C76.2, U12.4 (VBST)
unnamed: C79.2, R113.1, R116.2, U12.6 (VFB)
unnamed: R121.2, R124.1, U13.3 (+)
unnamed: R122.2, R126.1, U13.2 (-)
unnamed: R120.2, R123.1, U13.5 (+)
unnamed: R119.2, R125.1, U13.6 (-)
POWERGOOD: R110.1, U11.25 (PG); also elsewhere on the board

Notes on the sheet:
==TODO== NONE ==NOTAMS== PS Output 45W combined accross 5V and 3.3V to allow for accessory loads ISENSE Current amplifier values selected for 10A FSD to allow for off scale high detection
5V Buck converter
3.3V Buck converter
Decoupling
