Macquarie-Aerospace-Rover-Society/schematics/mqmars.kicad_pcb

## KiCad design mqmars.kicad_pcb (continued)

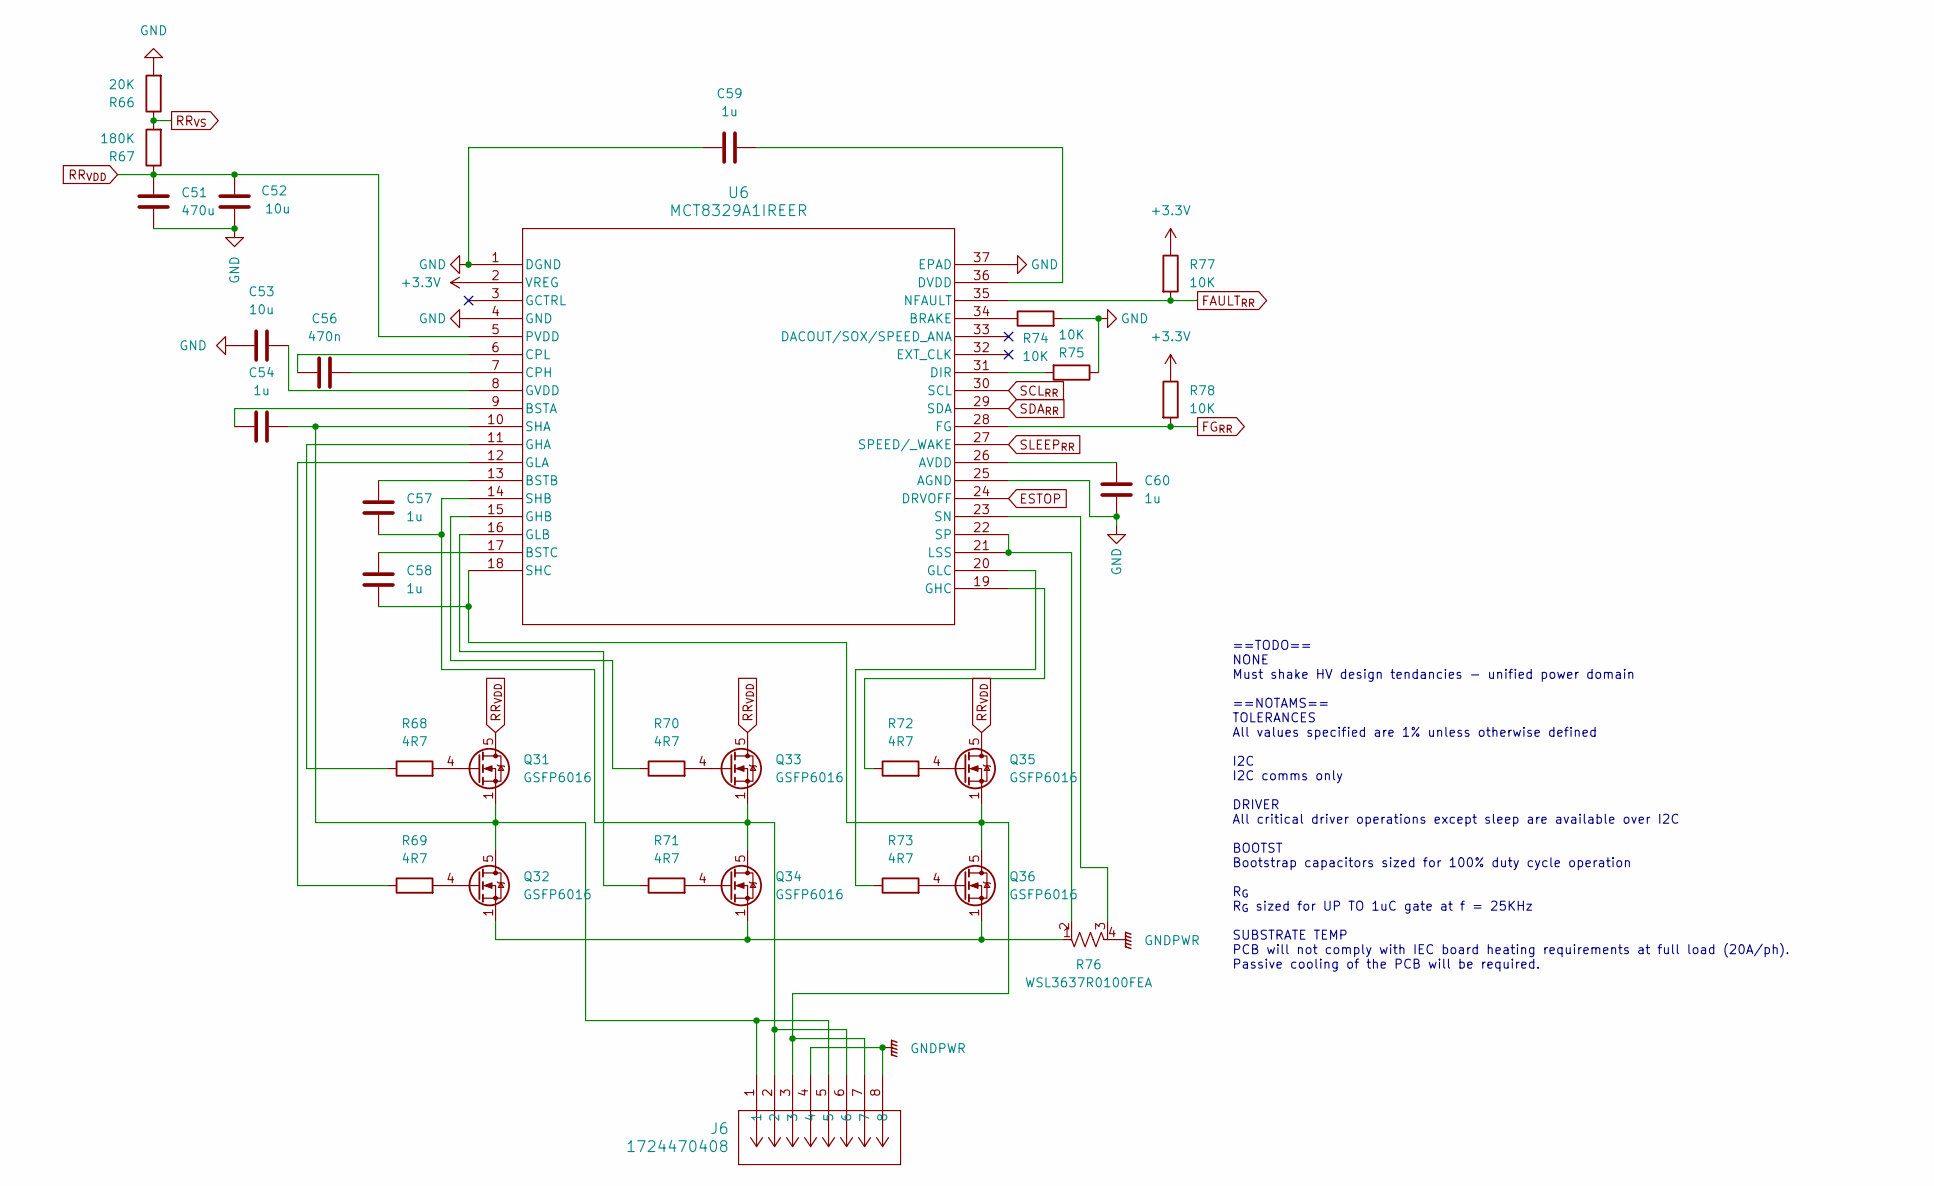
[picture p7: schematic RR.kicad_sch, MQ Rover Controller]

Parts:
C51: 470u; CP_Radial_D10.0mm_P5.00mm
C52: 10u; C_1210_3225Metric
C53: 10u; C_0402_1005Metric
C54, C57, C58, C59, C60: 1u; C_0201_0603Metric
C56: 470n; C_0201_0603Metric
J6: 1724470408; CONN08_1724470408_MOL
Q31, Q32, Q33, Q34, Q35, Q36: GSFP6016; PowerPAK_SO-8_Single
R66: 20K; R_0201_0603Metric
R67: 180K; R_0201_0603Metric
R68, R69, R70, R71, R72, R73: 4R7; R_0603_1608Metric
R74, R75, R77, R78: 10K; R_0201_0603Metric
R76: WSL3637R0100FEA; WSL3637_VIS
U6: MCT8329A1IREER; WQFN36_REE_TEX

Connections:
+3.3V: R77.1, R78.1, U6.2 (VREG); also elsewhere on the board
ESTOP: U6.24 (DRVOFF); also elsewhere on the board
FAULT_{RR}: R77.2, U6.35 (NFAULT); also elsewhere on the board
FG_{RR}: R78.2, U6.28 (FG)
GND: C51.2, C52.2, C53.1, C59.1, C60.1, R66.2, R74.2, R75.1, U6.1 (DGND), U6.4 (GND), U6.25 (AGND), U6.37 (EPAD); also elsewhere on the board
GNDPWR: J6.4, J6.8, R76.4; also elsewhere on the board
unnamed: Q31.4 (G), R68.2
unnamed: C54.1, J6.1, J6.5, Q31.1 (S), Q31.2 (S), Q31.3 (S), Q32.5 (D), U6.10 (SHA)
unnamed: Q32.4 (G), R69.2
unnamed: Q32.1 (S), Q32.2 (S), Q32.3 (S), Q34.1 (S), Q34.2 (S), Q34.3 (S), Q36.1 (S), Q36.2 (S), Q36.3 (S), R76.1
unnamed: Q33.4 (G), R70.2
unnamed: C57.2, J6.2, J6.6, Q33.1 (S), Q33.2 (S), Q33.3 (S), Q34.5 (D), U6.14 (SHB)
unnamed: Q34.4 (G), R71.2
unnamed: Q35.4 (G), R72.2
unnamed: C58.2, J6.3, J6.7, Q35.1 (S), Q35.2 (S), Q35.3 (S), Q36.5 (D), U6.18 (SHC)
unnamed: Q36.4 (G), R73.2
unnamed: C60.2, U6.26 (AVDD)
unnamed: R74.1, U6.34 (BRAKE)
unnamed: C54.2, U6.9 (BSTA)
unnamed: C57.1, U6.13 (BSTB)
unnamed: C58.1, U6.17 (BSTC)
unnamed: C56.1, U6.7 (CPH)
unnamed: C56.2, U6.6 (CPL)
unnamed: R75.2, U6.31 (DIR)
unnamed: C59.2, U6.36 (DVDD)
unnamed: R68.1, U6.11 (GHA)
unnamed: R70.1, U6.15 (GHB)
unnamed: R72.1, U6.19 (GHC)
unnamed: R69.1, U6.12 (GLA)
unnamed: R71.1, U6.16 (GLB)
unnamed: R73.1, U6.20 (GLC)
unnamed: C53.2, U6.8 (GVDD)
unnamed: R76.2, U6.21 (LSS), U6.22 (SP)
unnamed: R76.3, U6.23 (SN)
RR_{VDD}: C51.1, C52.1, Q31.5 (D), Q33.5 (D), Q35.5 (D), R67.1, U6.5 (PVDD); also elsewhere on the board
RR_{VS}: R66.1, R67.2; also elsewhere on the board
SCL_{RR}: U6.30 (SCL); also elsewhere on the board
SDA_{RR}: U6.29 (SDA); also elsewhere on the board
SLEEP_{RR}: U6.27 (SPEED/_WAKE)

Notes on the sheet:
==TODO== NONE Must shake HV design tendancies - unified power domain ==NOTAMS== TOLERANCES All values specified are 1% unless otherwise defined I2C I2C comms only DRIVER All critical driver operations except sleep are available over I2C BOOTST Bootstrap capacitors sized for 100% duty cycle operatio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

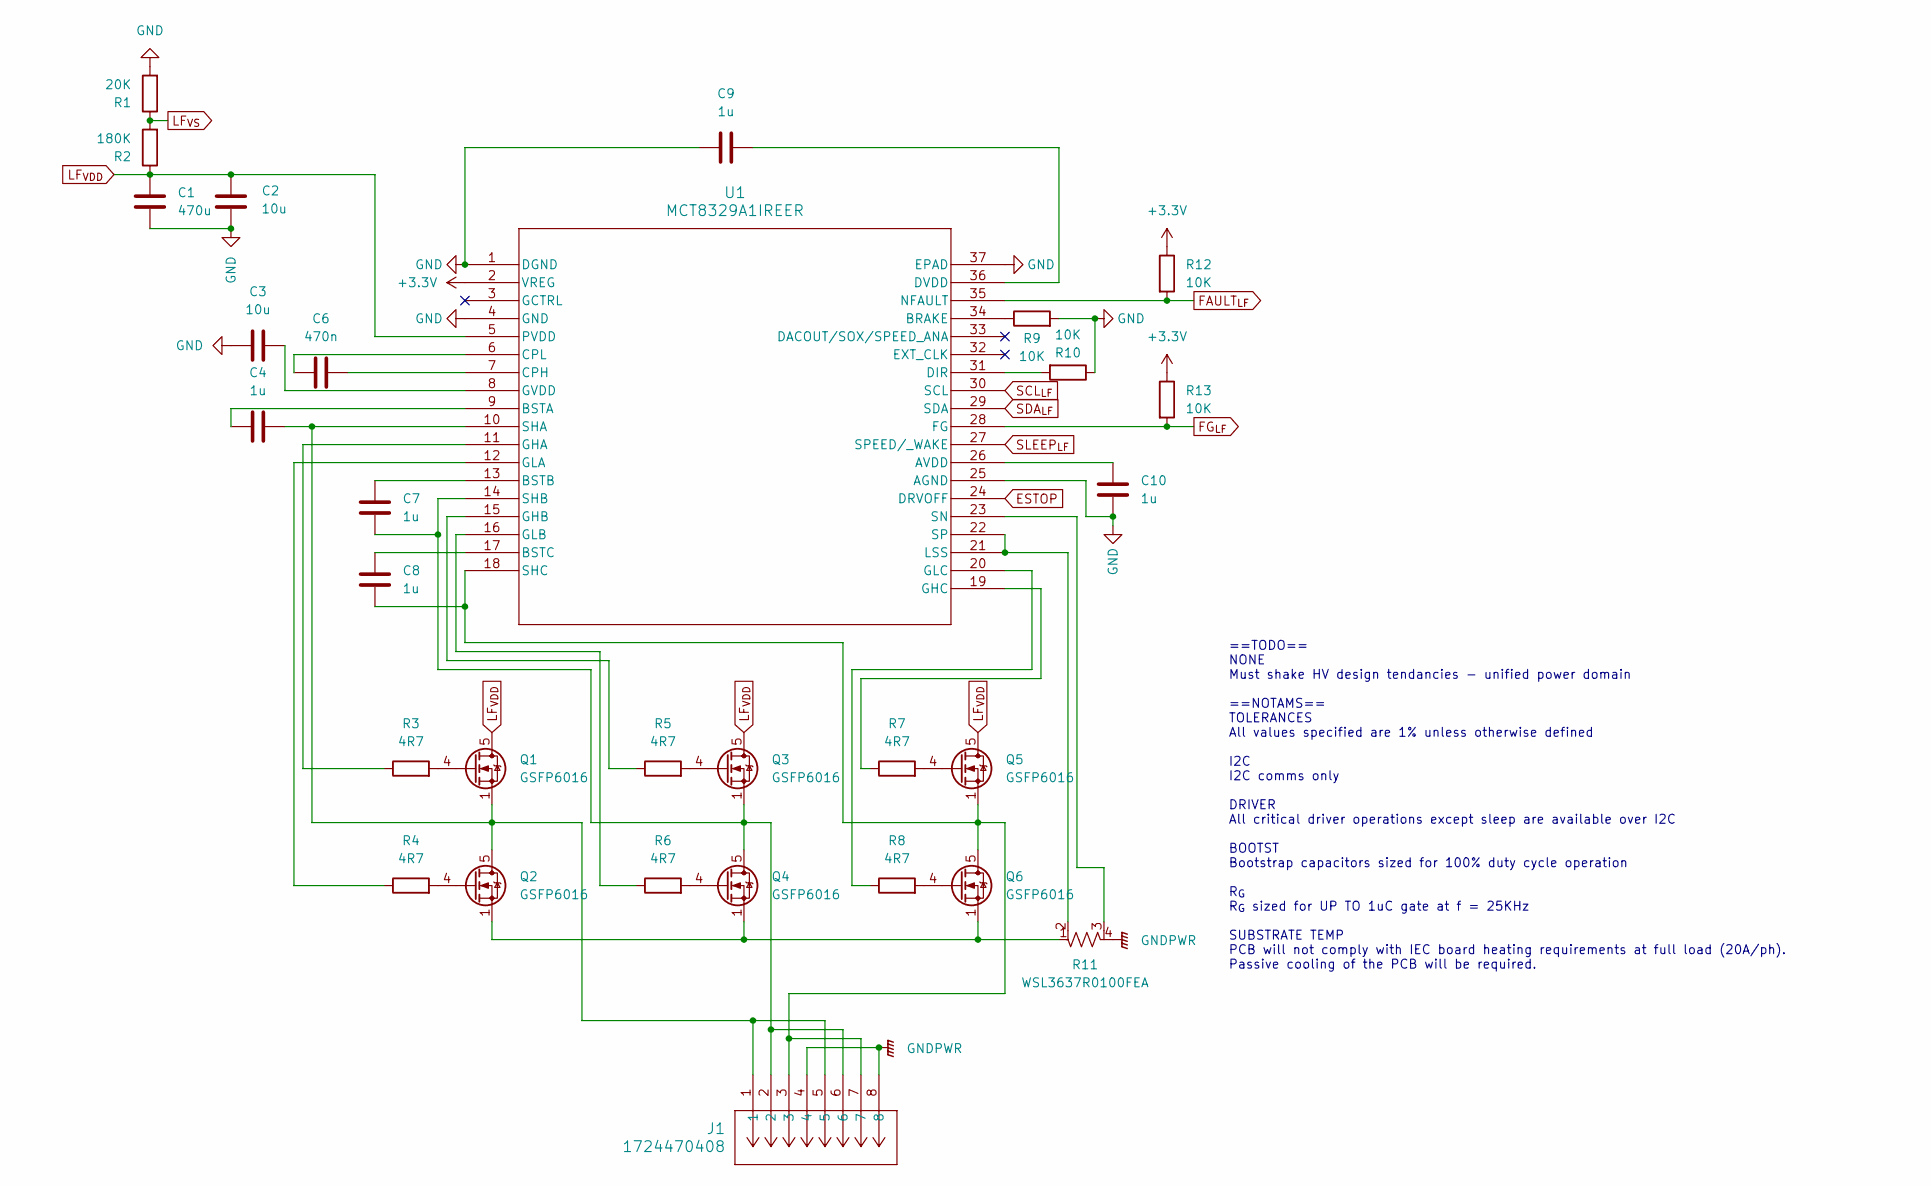
[picture p8: schematic LF.kicad_sch, MQ Rover Controller]

Parts:
C1: 470u; CP_Radial_D10.0mm_P5.00mm
C2: 10u; C_1210_3225Metric
C3: 10u; C_0402_1005Metric
C4, C7, C8, C9, C10: 1u; C_0201_0603Metric
C6: 470n; C_0201_0603Metric
J1: 1724470408; CONN08_1724470408_MOL
Q1, Q2, Q3, Q4, Q5, Q6: GSFP6016; PowerPAK_SO-8_Single
R1: 20K; R_0201_0603Metric
R2: 180K; R_0201_0603Metric
R3, R4, R5, R6, R7, R8: 4R7; R_0603_1608Metric
R9, R10, R12, R13: 10K; R_0201_0603Metric
R11: WSL3637R0100FEA; WSL3637_VIS
U1: MCT8329A1IREER; WQFN36_REE_TEX

Connections:
+3.3V: R12.1, R13.1, U1.2 (VREG); also elsewhere on the board
ESTOP: U1.24 (DRVOFF); also elsewhere on the board
FAULT_{LF}: R12.2, U1.35 (NFAULT); also elsewhere on the board
FG_{LF}: R13.2, U1.28 (FG)
GND: C1.2, C2.2, C3.1, C9.1, C10.1, R1.2, R9.2, R10.1, U1.1 (DGND), U1.4 (GND), U1.25 (AGND), U1.37 (EPAD); also elsewhere on the board
GNDPWR: J1.4, J1.8, R11.4; also elsewhere on the board
LF_{VDD}: C1.1, C2.1, Q1.5 (D), Q3.5 (D), Q5.5 (D), R2.1, U1.5 (PVDD); also elsewhere on the board
LF_{VS}: R1.1, R2.2; also elsewhere on the board
unnamed: Q1.4 (G), R3.2
unnamed: C4.1, J1.1, J1.5, Q1.1 (S), Q1.2 (S), Q1.3 (S), Q2.5 (D), U1.10 (SHA)
unnamed: Q2.4 (G), R4.2
unnamed: Q2.1 (S), Q2.2 (S), Q2.3 (S), Q4.1 (S), Q4.2 (S), Q4.3 (S), Q6.1 (S), Q6.2 (S), Q6.3 (S), R11.1
unnamed: Q3.4 (G), R5.2
unnamed: C7.2, J1.2, J1.6, Q3.1 (S), Q3.2 (S), Q3.3 (S), Q4.5 (D), U1.14 (SHB)
unnamed: Q4.4 (G), R6.2
unnamed: Q5.4 (G), R7.2
unnamed: C8.2, J1.3, J1.7, Q5.1 (S), Q5.2 (S), Q5.3 (S), Q6.5 (D), U1.18 (SHC)
unnamed: Q6.4 (G), R8.2
unnamed: C10.2, U1.26 (AVDD)
unnamed: R9.1, U1.34 (BRAKE)
unnamed: C4.2, U1.9 (BSTA)
unnamed: C7.1, U1.13 (BSTB)
unnamed: C8.1, U1.17 (BSTC)
unnamed: C6.1, U1.7 (CPH)
unnamed: C6.2, U1.6 (CPL)
unnamed: R10.2, U1.31 (DIR)
unnamed: C9.2, U1.36 (DVDD)
unnamed: R3.1, U1.11 (GHA)
unnamed: R5.1, U1.15 (GHB)
unnamed: R7.1, U1.19 (GHC)
unnamed: R4.1, U1.12 (GLA)
unnamed: R6.1, U1.16 (GLB)
unnamed: R8.1, U1.20 (GLC)
unnamed: C3.2, U1.8 (GVDD)
unnamed: R11.2, U1.21 (LSS), U1.22 (SP)
unnamed: R11.3, U1.23 (SN)
SCL_{LF}: U1.30 (SCL); also elsewhere on the board
SDA_{LF}: U1.29 (SDA); also elsewhere on the board
SLEEP_{LF}: U1.27 (SPEED/_WAKE); also elsewhere on the board

Notes on the sheet:
==TODO== NONE Must shake HV design tendancies - unified power domain ==NOTAMS== TOLERANCES All values specified are 1% unless otherwise defined I2C I2C comms only DRIVER All critical driver operations except sleep are available over I2C BOOTST Bootstrap capacitors sized for 100% duty cycle operatio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

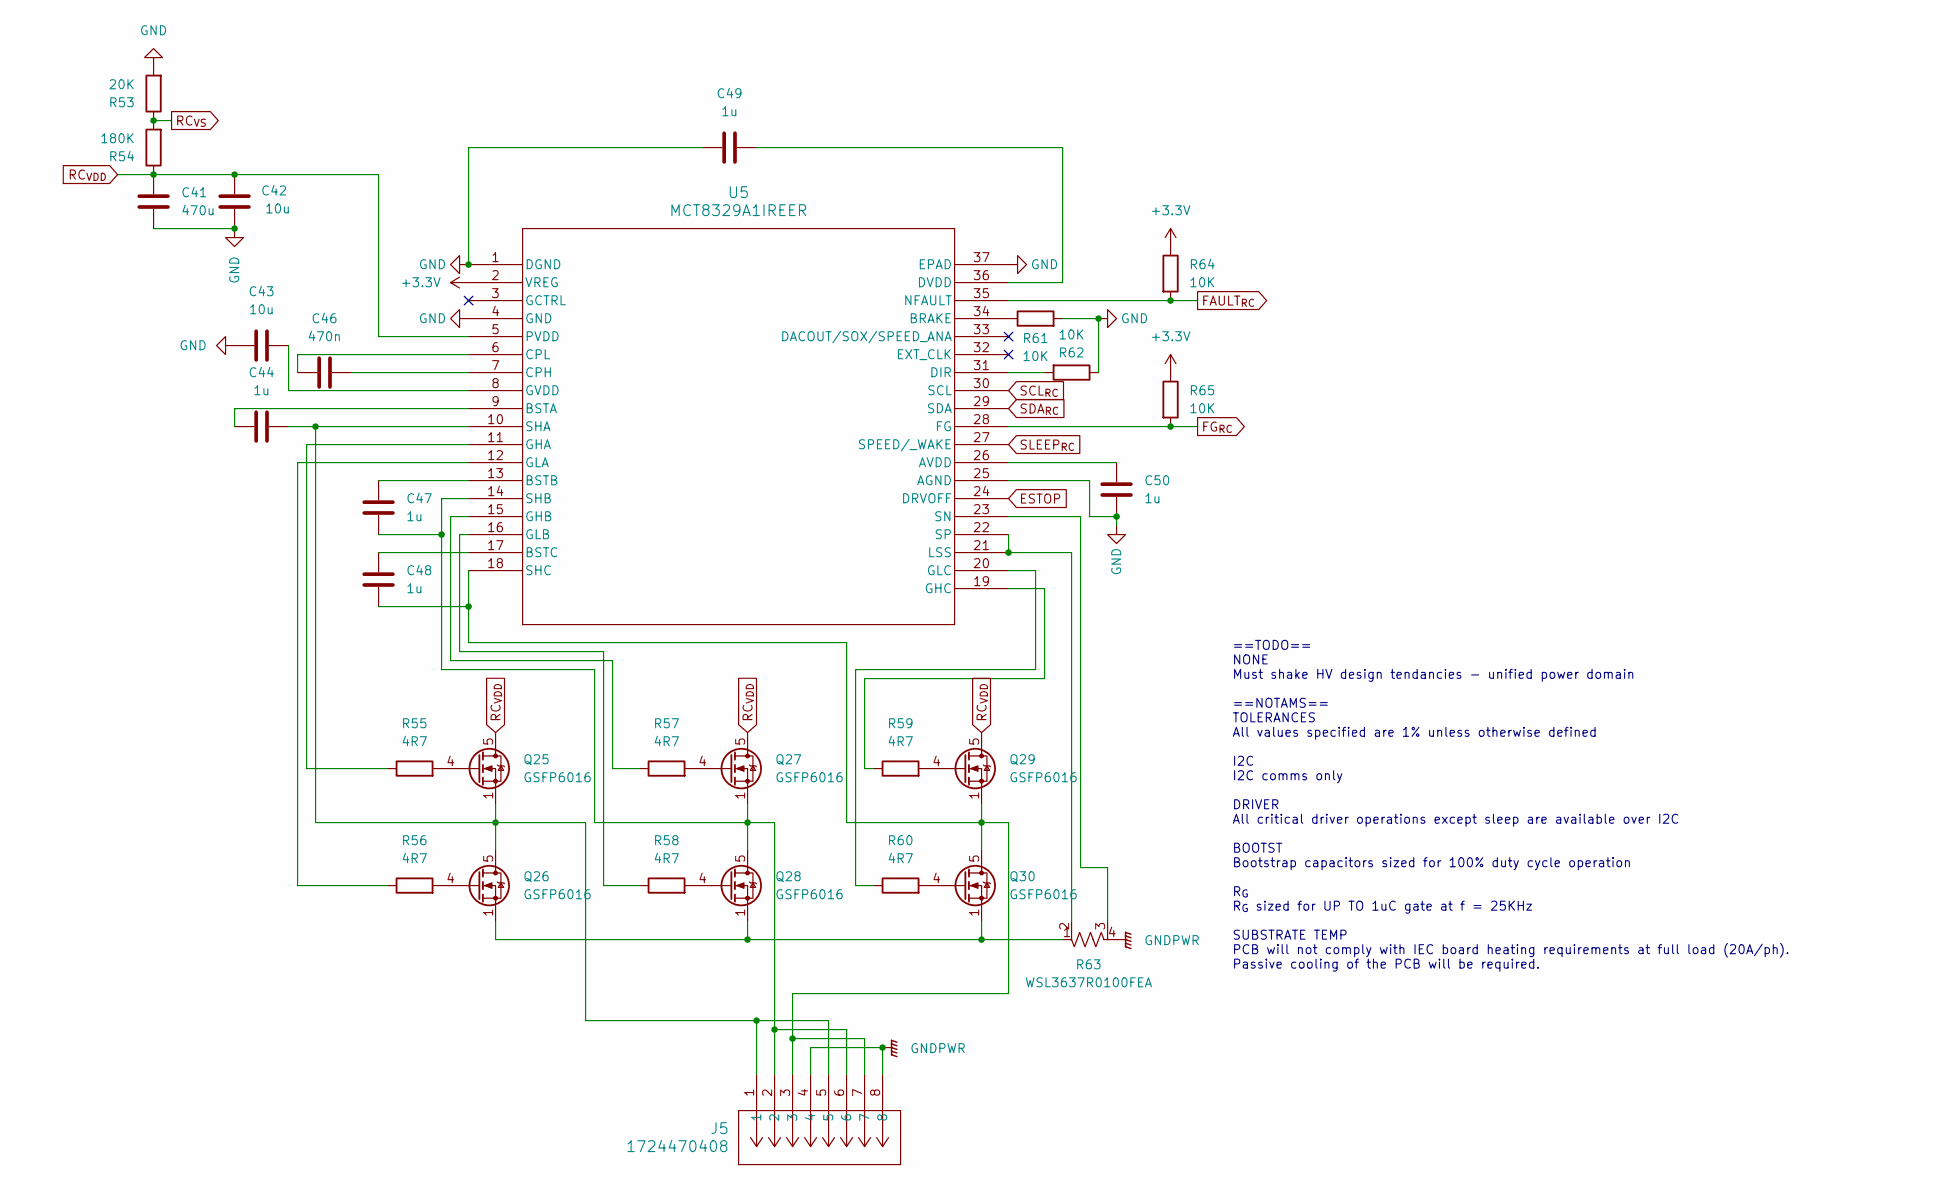
[picture p9: schematic RC.kicad_sch, MQ Rover Controller]

Parts:
C41: 470u; CP_Radial_D10.0mm_P5.00mm
C42: 10u; C_1210_3225Metric
C43: 10u; C_0402_1005Metric
C44, C47, C48, C49, C50: 1u; C_0201_0603Metric
C46: 470n; C_0201_0603Metric
J5: 1724470408; CONN08_1724470408_MOL
Q25, Q26, Q27, Q28, Q29, Q30: GSFP6016; PowerPAK_SO-8_Single
R53: 20K; R_0201_0603Metric
R54: 180K; R_0201_0603Metric
R55, R56, R57, R58, R59, R60: 4R7; R_0603_1608Metric
R61, R62, R64, R65: 10K; R_0201_0603Metric
R63: WSL3637R0100FEA; WSL3637_VIS
U5: MCT8329A1IREER; WQFN36_REE_TEX

Connections:
+3.3V: R64.1, R65.1, U5.2 (VREG); also elsewhere on the board
ESTOP: U5.24 (DRVOFF); also elsewhere on the board
FAULT_{RC}: R64.2, U5.35 (NFAULT); also elsewhere on the board
FG_{RC}: R65.2, U5.28 (FG)
GND: C41.2, C42.2, C43.1, C49.1, C50.1, R53.2, R61.2, R62.1, U5.1 (DGND), U5.4 (GND), U5.25 (AGND), U5.37 (EPAD); also elsewhere on the board
GNDPWR: J5.4, J5.8, R63.4; also elsewhere on the board
unnamed: Q25.4 (G), R55.2
unnamed: C44.1, J5.1, J5.5, Q25.1 (S), Q25.2 (S), Q25.3 (S), Q26.5 (D), U5.10 (SHA)
unnamed: Q26.4 (G), R56.2
unnamed: Q26.1 (S), Q26.2 (S), Q26.3 (S), Q28.1 (S), Q28.2 (S), Q28.3 (S), Q30.1 (S), Q30.2 (S), Q30.3 (S), R63.1
unnamed: Q27.4 (G), R57.2
unnamed: C47.2, J5.2, J5.6, Q27.1 (S), Q27.2 (S), Q27.3 (S), Q28.5 (D), U5.14 (SHB)
unnamed: Q28.4 (G), R58.2
unnamed: Q29.4 (G), R59.2
unnamed: C48.2, J5.3, J5.7, Q29.1 (S), Q29.2 (S), Q29.3 (S), Q30.5 (D), U5.18 (SHC)
unnamed: Q30.4 (G), R60.2
unnamed: C50.2, U5.26 (AVDD)
unnamed: R61.1, U5.34 (BRAKE)
unnamed: C44.2, U5.9 (BSTA)
unnamed: C47.1, U5.13 (BSTB)
unnamed: C48.1, U5.17 (BSTC)
unnamed: C46.1, U5.7 (CPH)
unnamed: C46.2, U5.6 (CPL)
unnamed: R62.2, U5.31 (DIR)
unnamed: C49.2, U5.36 (DVDD)
unnamed: R55.1, U5.11 (GHA)
unnamed: R57.1, U5.15 (GHB)
unnamed: R59.1, U5.19 (GHC)
unnamed: R56.1, U5.12 (GLA)
unnamed: R58.1, U5.16 (GLB)
unnamed: R60.1, U5.20 (GLC)
unnamed: C43.2, U5.8 (GVDD)
unnamed: R63.2, U5.21 (LSS), U5.22 (SP)
unnamed: R63.3, U5.23 (SN)
RC_{VDD}: C41.1, C42.1, Q25.5 (D), Q27.5 (D), Q29.5 (D), R54.1, U5.5 (PVDD); also elsewhere on the board
RC_{VS}: R53.1, R54.2; also elsewhere on the board
SCL_{RC}: U5.30 (SCL); also elsewhere on the board
SDA_{RC}: U5.29 (SDA); also elsewhere on the board
SLEEP_{RC}: U5.27 (SPEED/_WAKE)

Notes on the sheet:
==TODO== NONE Must shake HV design tendancies - unified power domain ==NOTAMS== TOLERANCES All values specified are 1% unless otherwise defined I2C I2C comms only DRIVER All critical driver operations except sleep are available over I2C BOOTST Bootstrap capacitors sized for 100% duty cycle operatio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

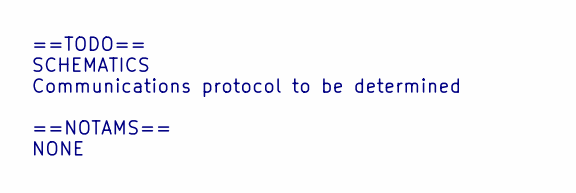
[picture p10: schematic Jetson IF.kicad_sch, MQ Rover Controller]

Notes on the sheet:
==TODO== SCHEMATICS Communications protocol to be determined ==NOTAMS== NONE

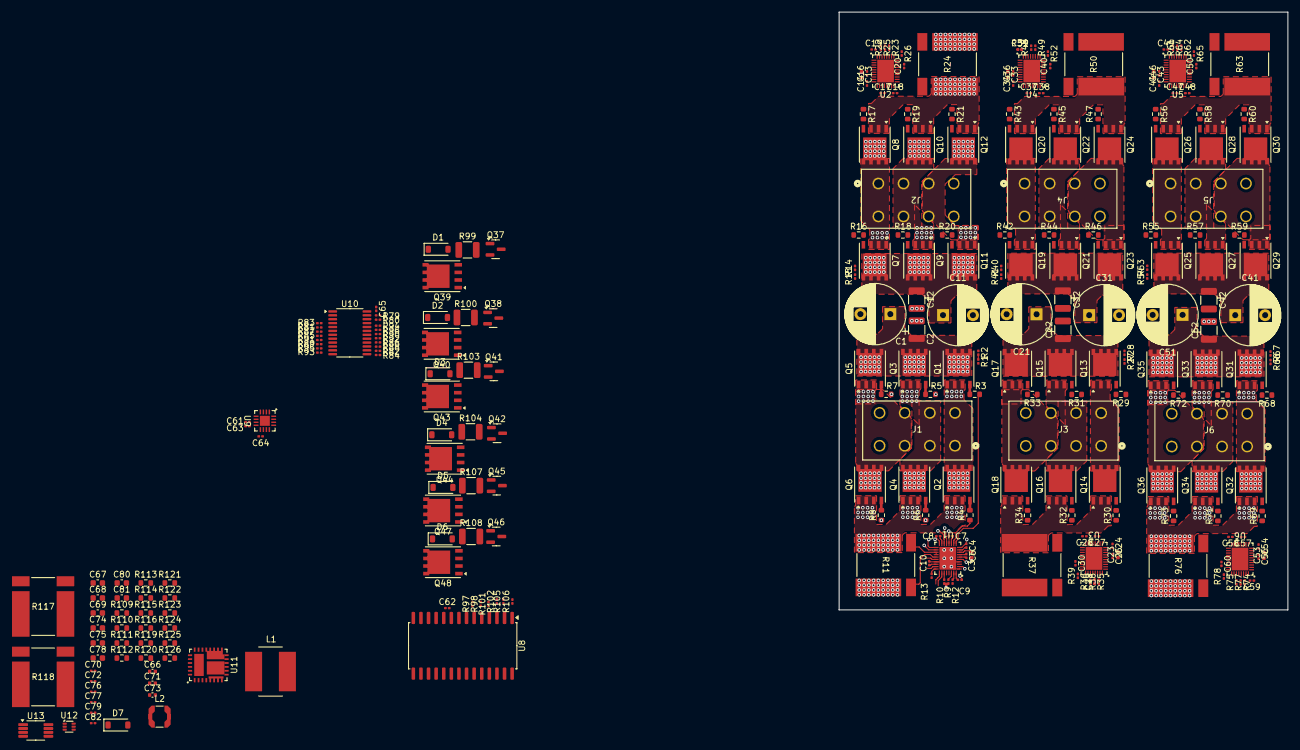
[picture p11: board mqmars.kicad_pcb from above]

Board: 4 copper layers, 75.0 x 99.9 mm, 277 parts (0 on the bottom side), 268 nets.
