Macquarie-Aerospace-Rover-Society/schematics/(commit log)

2024-12-24 Revision A
    Initial upload - decisions pending
    [Interposer.kicad_sch, Jetson IF.kicad_sch, LC.kicad_sch, LF.kicad_sch, LR.kicad_sch, PDU.kicad_sch, PS.kicad_sch, RC.kicad_sch]
2024-12-24 moved some designators to identify pullup resistors
    [Interposer.kicad_sch]
2024-12-26 The great decluttering
    Moved all possible controls to I2C, part selection commenced, IOs assigned pending comms schema
    [Interposer.kicad_sch, LC.kicad_sch, LF.kicad_sch, LR.kicad_sch, PDU.kicad_sch, PS.kicad_sch, RC.kicad_sch, RF.kicad_sch]
2024-12-28 Powerstage
    Powerstage layout, non critical changes to schematic
    [Interposer.kicad_sch, LC.kicad_sch, LF.kicad_sch, LR.kicad_sch, PDU.kicad_sch, PS.kicad_sch, RC.kicad_sch, RF.kicad_sch]
